DarwinMu/Geolocalizaci-n/Dashboard.png

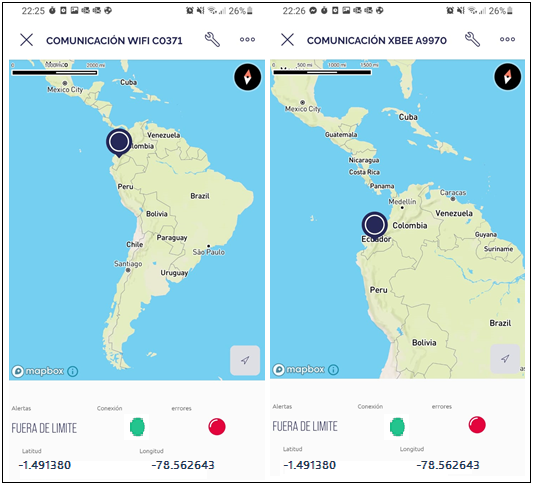
Dashboard.png
